omarcely/Roberto2021/Tests/ImageCapture/First Selfie.jpeg

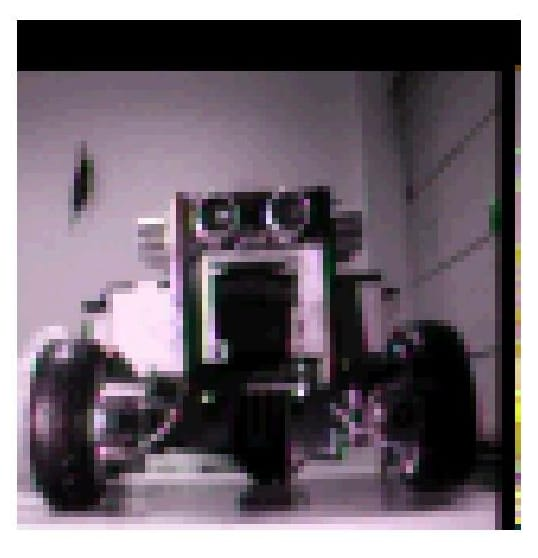
Tests/ImageCapture/First Selfie.jpeg
