omarcely/Roberto2021/(commit log)

2021-06-10 Frame indicator added but only partially
2021-06-10 Frame indicator fully Added (still preeliminary, no tests yet)
2021-06-11 CHanges during the wiring, I'm tired and sad :c
2021-06-15 The issue with the two clock signals was appearently fixed
    [ReadImage.v, ZyboZ7.xdc]
2021-06-15 Some sintax errors were fixed
    [Main.v, ReadImage.v, ZyboZ7.xdc]
2021-06-16 First try to fix the PLK issue
    [Main.v, ReadImage.v, ZyboZ7.xdc]
2021-06-19 RAM Enable Read was unconnected, that's now fixed
    [Main.v]
2021-06-19 Some data was sended to the ESP32
2021-06-21 Update Config.ino
    Remove the serial print of the registers.
    Change Serial.begin baudrate.
    Add "for" in serial2 reading.
    Add concatenation to the serial print of pixels.
2021-06-21 ESP32 reading fixed
2021-06-28 First try to fix the 0-beginning trouble
    [ReadImage.v]
2021-06-28 0-beginning trouble almost fixed
    [Main.v, ReadImage.v, Tx.v]
2021-06-29 Update CameraCapture.py
    First try of video reproduction with the camera
2021-06-30 The Camera is finally working c: pd: siuuuuuuuuuuuu
2021-07-01 Add files via upload
    Here are all the files that we need, even the camera's configuration.
